davidcool/Mr-Roboto/README.md

# Mr-Roboto
Laser cut micro-controller based robot toy.

Kits available at:
http://shop.davidcool.com

<h2>Mr. Roboto Project</h2>
This project has all the files needed to laser cut and build a robot and control box.

It uses:
- 1x Arduino Pro Micro
- 1x 1P4T (1 pole 4 throw) switch - used for mode functions.
- 4x micro servos
- 4x 10K linear potentiometers
- 1x 3.5mm stereo female jack - 3 leads, TX, RX and GND used for serial communication with Mr. Touch Key project.
- 1x Micro USB breakout board - only using GND & VCC to supply power for project
- 1x 5V 3A power supply with a micro USB connector - used to supply project power
- 22AWG hookup wire used for all connections and to create the control cable
- 8mm shrink tube to create the control cable
- 2x rubber grommets for cable interface points
- 12mm M3 flathead hex bolts & nuts for attaching parts
- 4x knobs for potentiometers
- 1x knob for switch
- 1/2 inch copper tape (for +5V & GND rails so young learners can more easily solder)

Tools:
- Soldering Iron
- Solder
- Helping hands
- Glue gun
- Wire strippers
- 2mm hex wrench/driver
- 3D printer
- Laser cutter

If you don't have accerss to a laser cutter or 3D printer, these projects are available as kits at:
http://shop.davidcool.com

This project is designed to interact with another project, Mr. Touch Key found here:
https://github.com/davidcool/Mr-Touch-Key

- In mode 1 each of the 4 servos are controlled by a corresponding potentiometer for manual control of the robot.
- In mode 2 all the servos do a sweeping motion so the robot moves automatically, the potentiometers control the sweep speed.
- In mode 3 on Mr. Roboto as the robot moves it sends random MIDI notes to the Mr. Touch Key keyboard to be played.
- In mode 4 on Mr. Roboto as the Mr. Touch Key keyboard is played different parts of the robot will move.

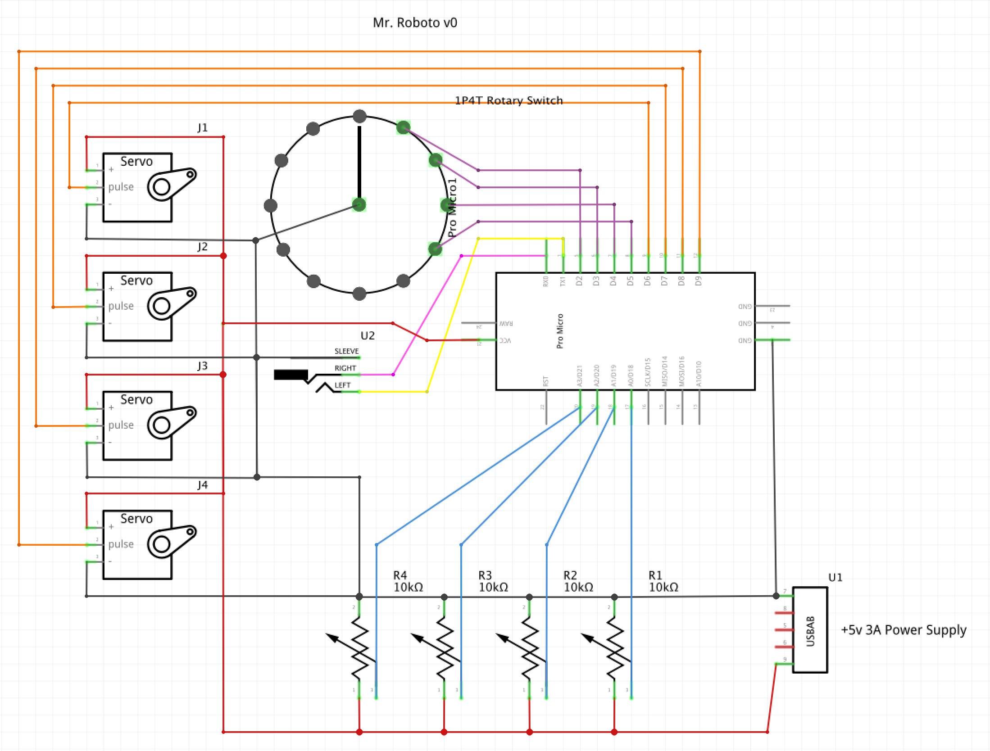
[picture p1: _pictures/mr_roboto_schematic_v2.png]

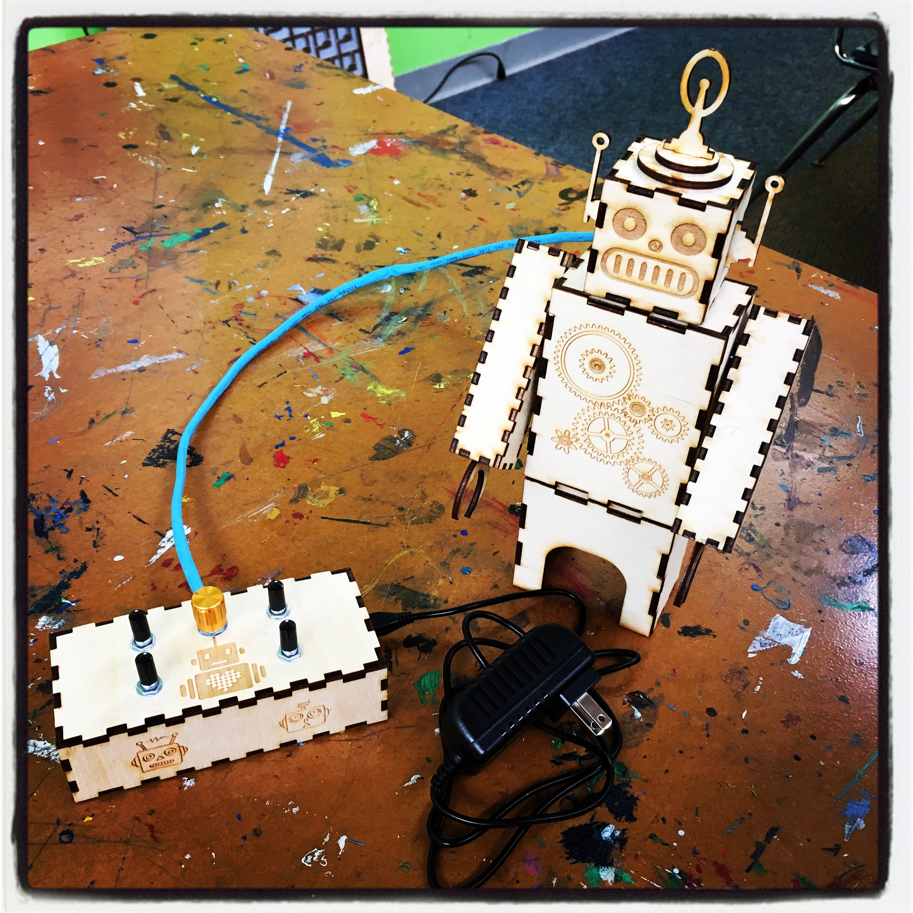
[picture p2: _pictures/IMG_6931.jpg]

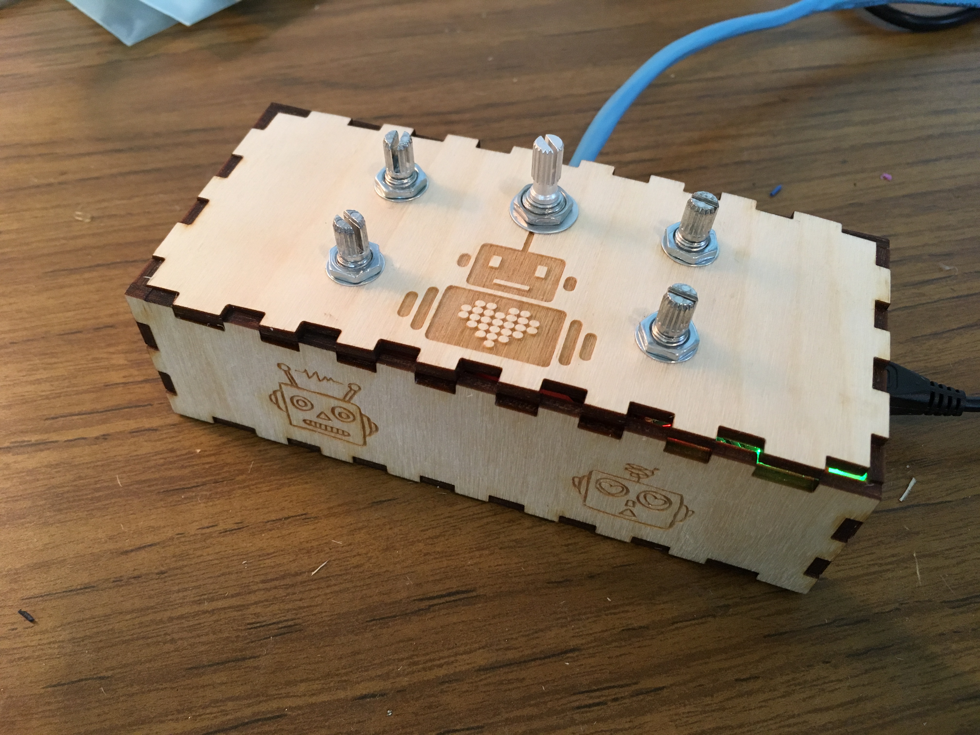
[picture p3: _pictures/IMG_6925.jpg]

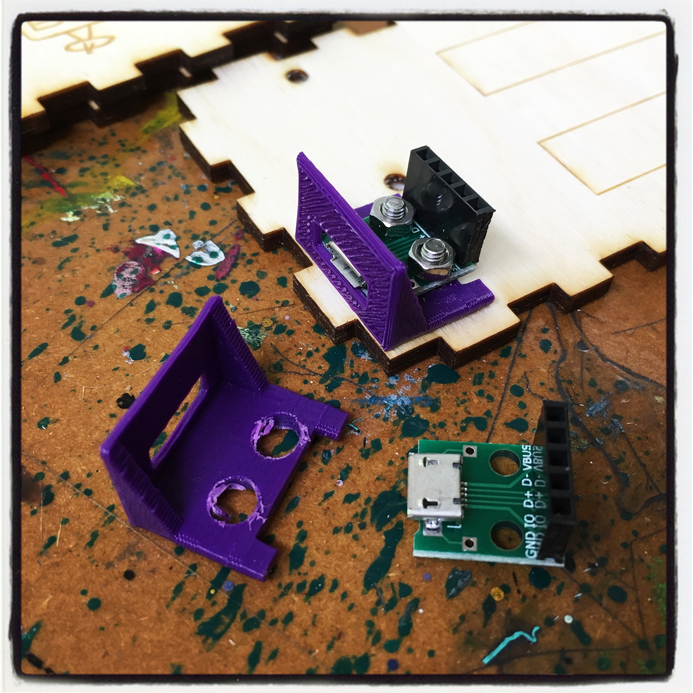
[picture p4: _pictures/IMG_6933.jpg]

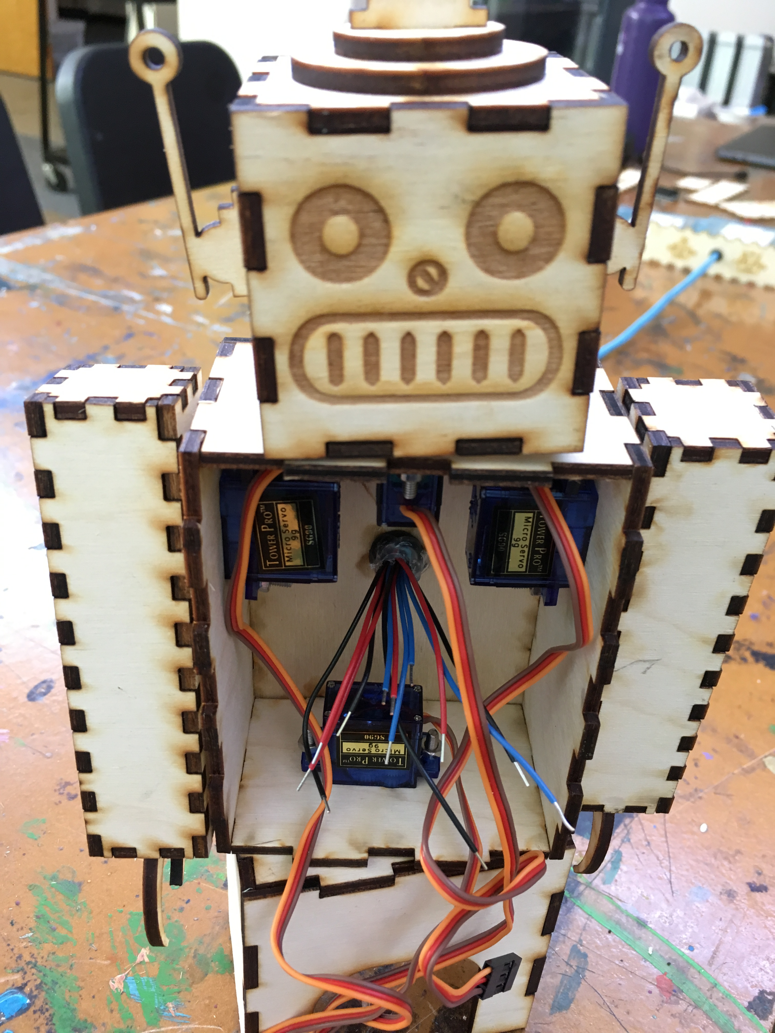
[picture p5: _pictures/IMG_6910.jpg]

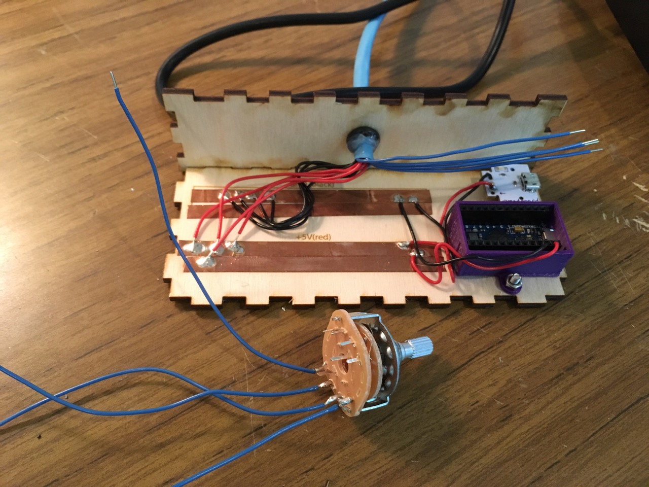
[picture p6: _pictures/IMG_6915.jpg]

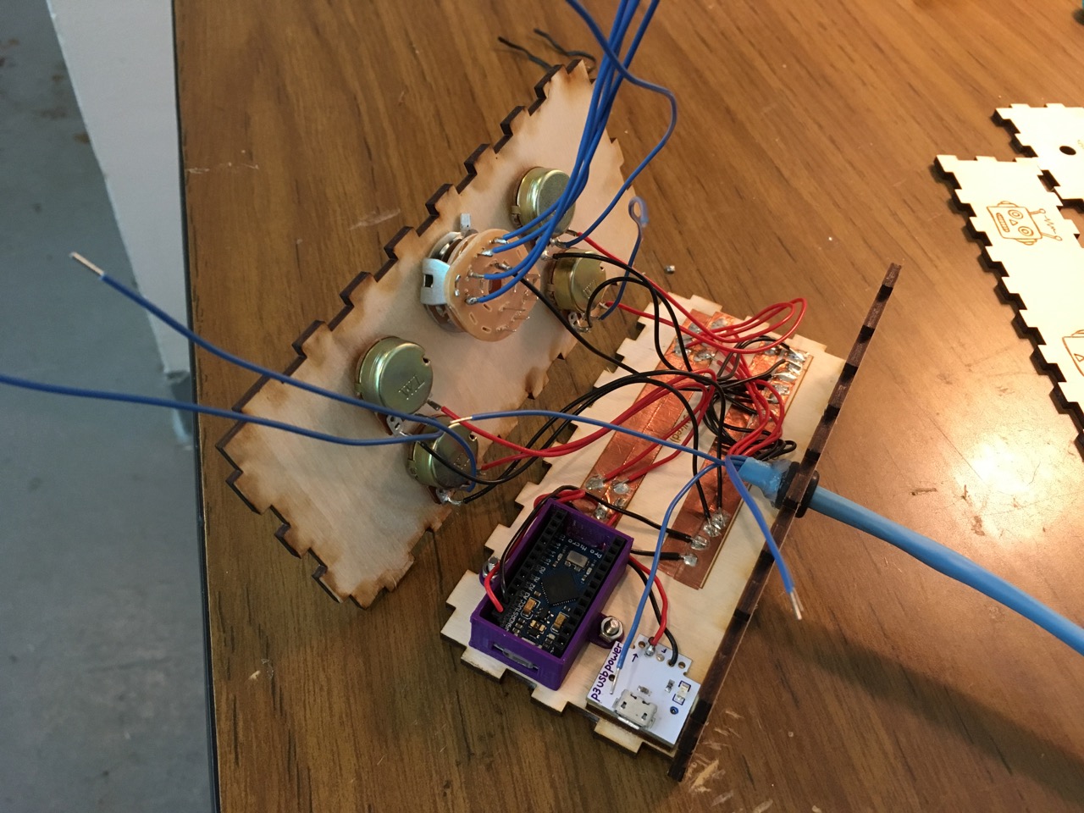
[picture p7: _pictures/IMG_6919.jpg]
