davidcool/Mr-Roboto/_pictures/IMG_6923.jpg

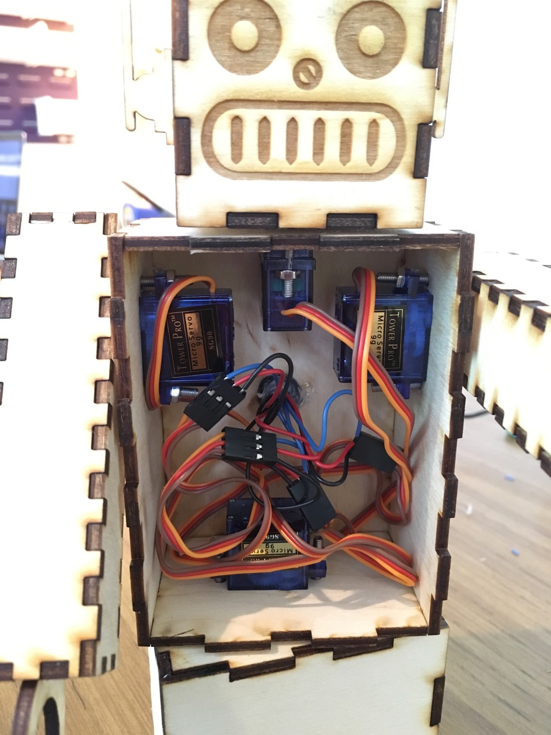
_pictures/IMG_6923.jpg
