davidcool/Mr-Roboto/_3D files/micro_usb_pcb_breakout v6.stl

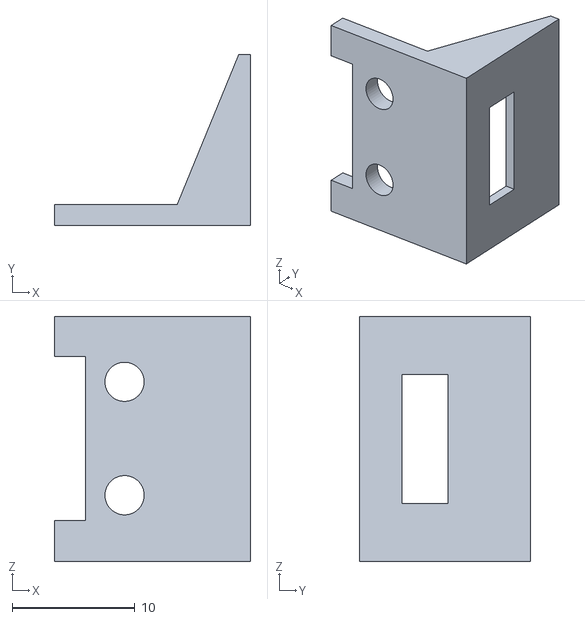
[picture p9: CAD file, 2018-09-09]
_3D files/micro_usb_pcb_breakout v6.stl
16.0 x 14.0 x 20.0
