davidcool/Mr-Roboto/_3D files/Arduino_Box_Leonardo_Pro_Mini.stl

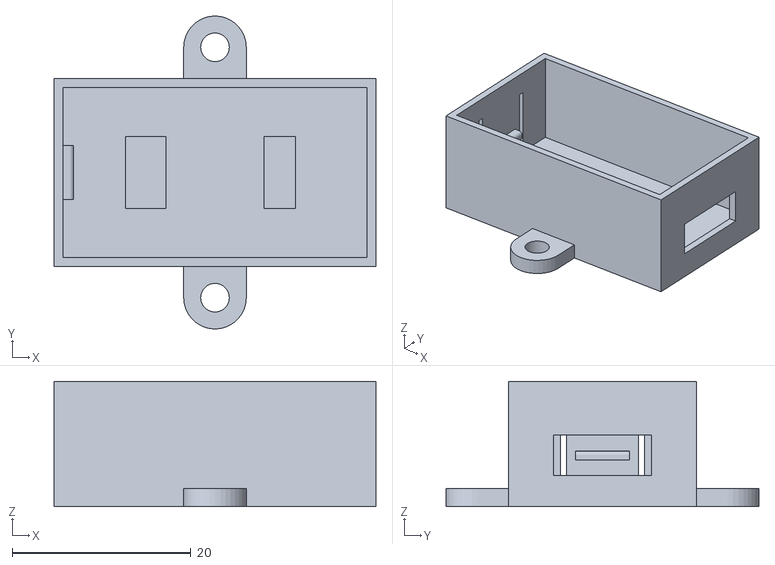
[picture p10: CAD file, 2018-09-09]
_3D files/Arduino_Box_Leonardo_Pro_Mini.stl
36.0 x 35.0 x 14.0
