davidcool/Mr-Roboto/(list of files, cad)

Other CAD files:
_3D files/micro_usb_pcb_breakout v6.f3d
